legokor/drone/FC_hardware/FC/Symbols/snapeda/3dmodels/SM08B-SRSS-TB.step

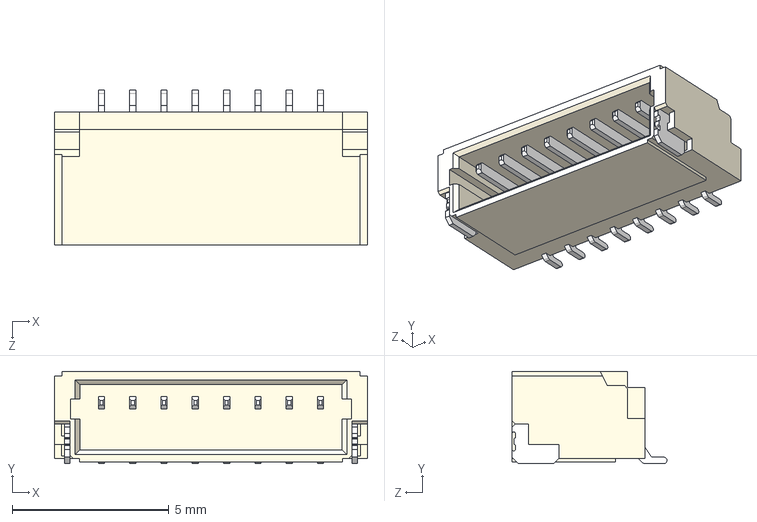
[picture p2: CAD file, 2024-11-20]
FC_hardware/FC/Symbols/snapeda/3dmodels/SM08B-SRSS-TB.step
10.00 x 2.95 x 4.95 mm
