legokor/drone/FC_hardware/FC/FC.kicad_pcb

## KiCad design FC_hardware/FC/FC.kicad_pcb (2024-11-20)

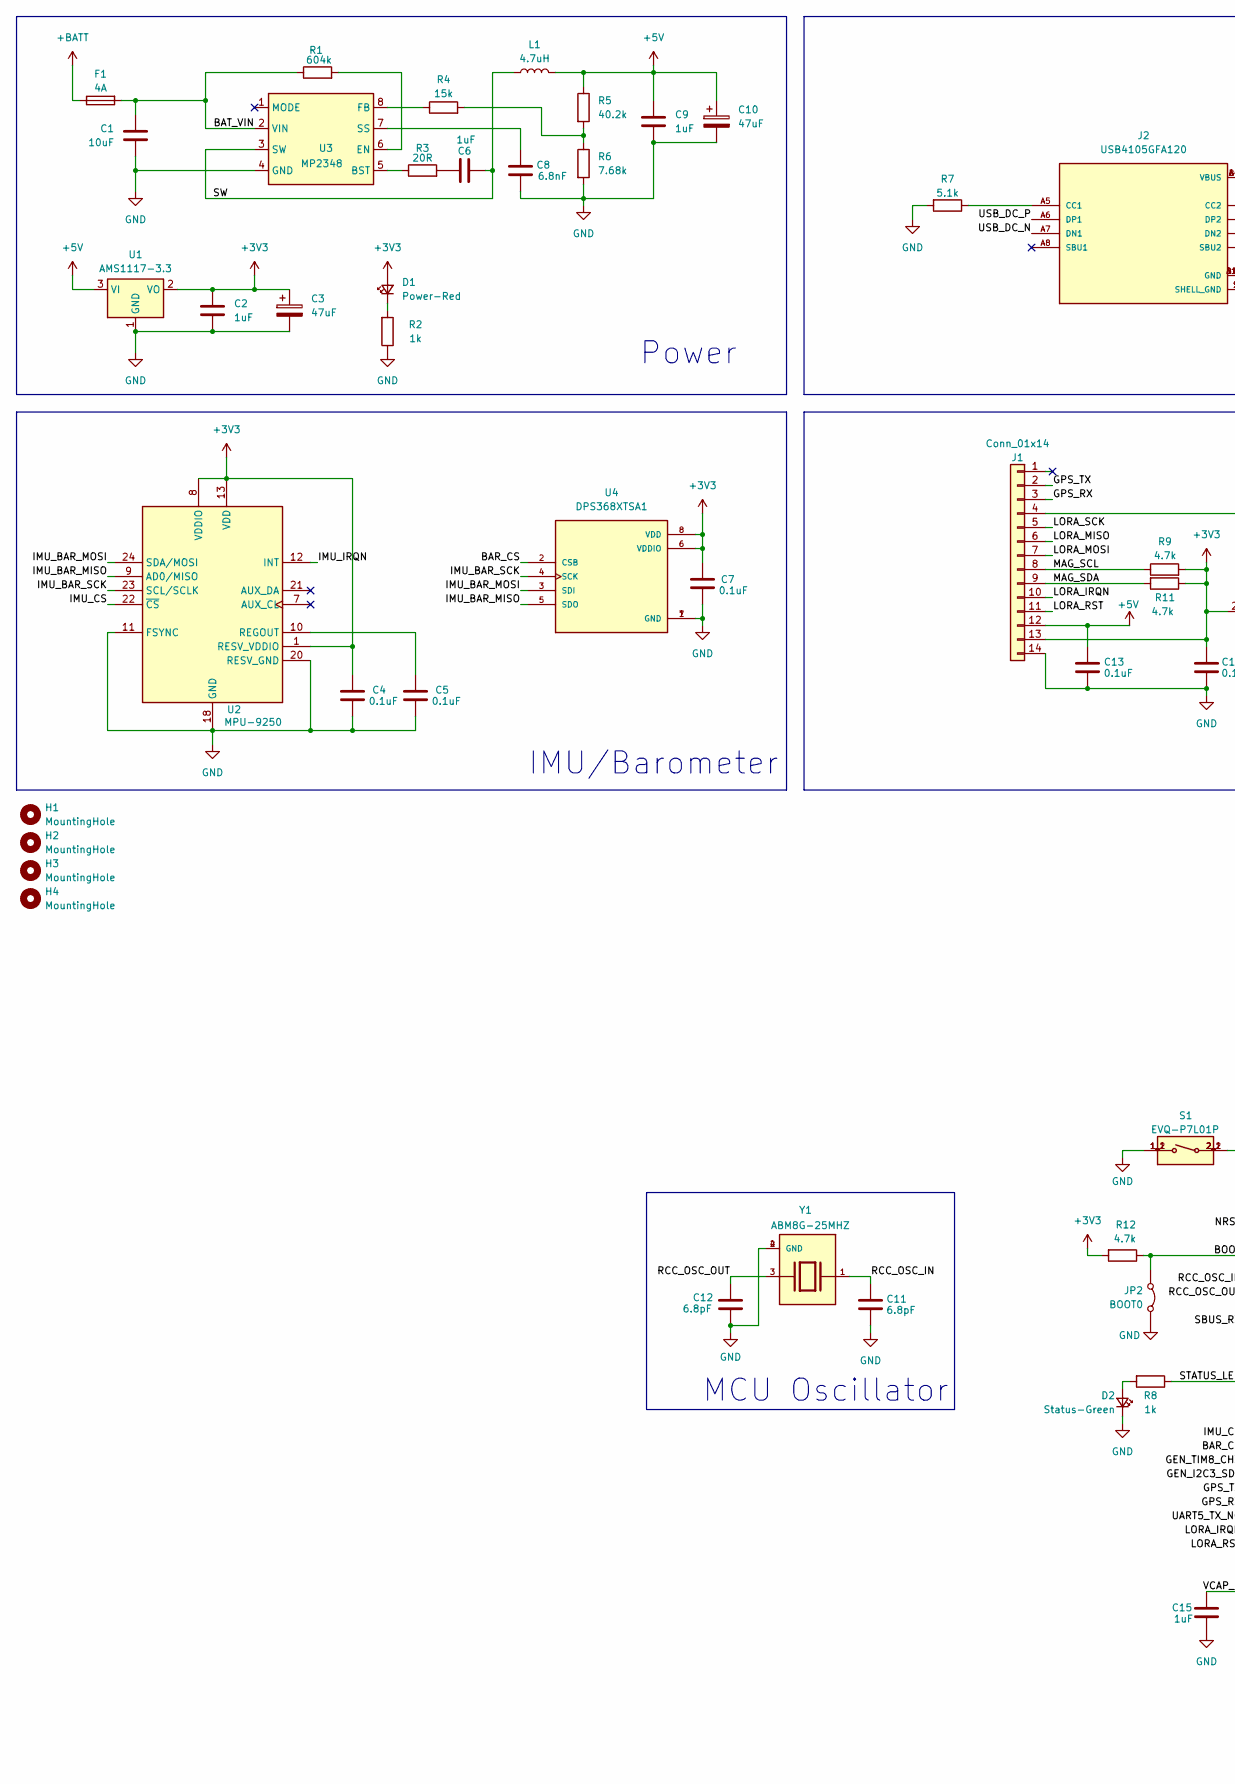
[picture p3: schematic FC.kicad_sch, Drone FC, part in row 1, column 1]

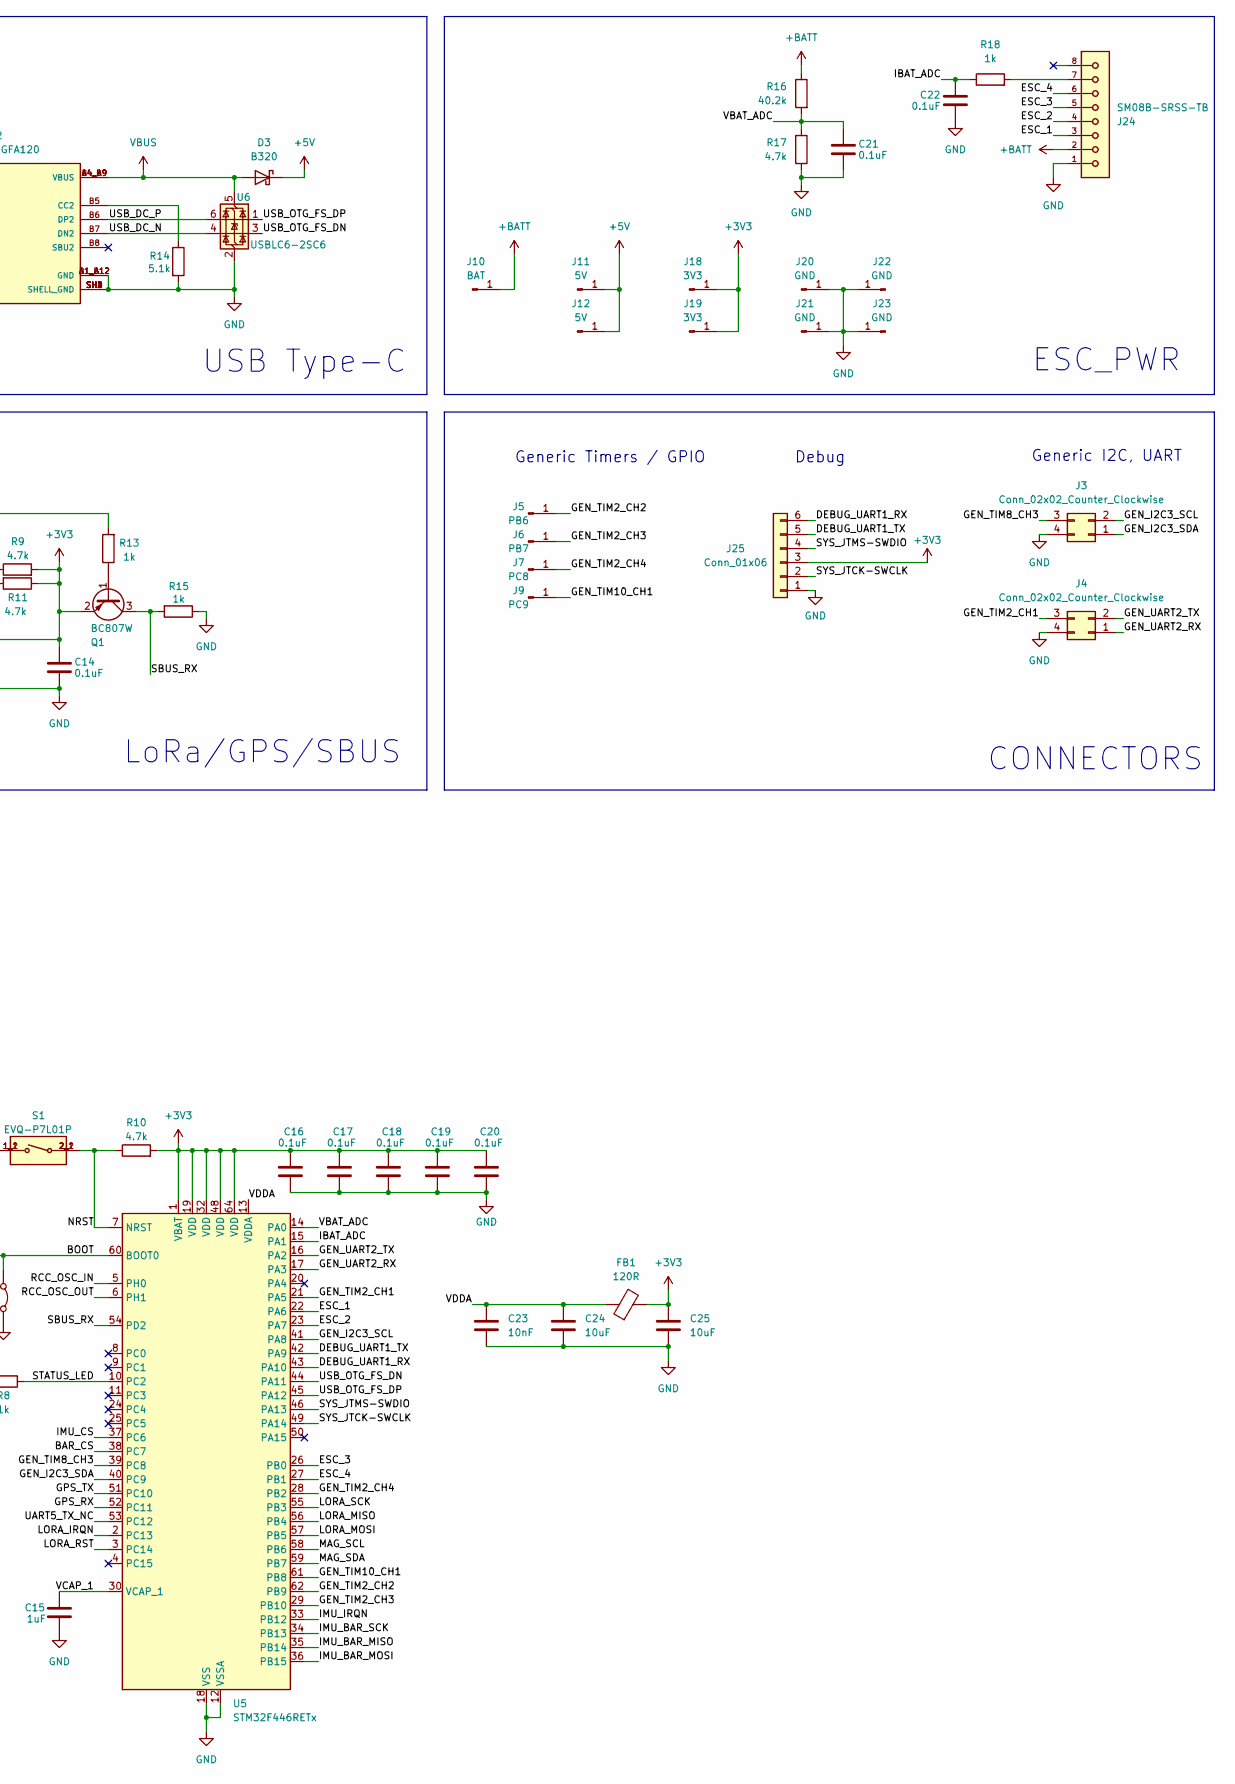
[picture p4: schematic FC.kicad_sch, Drone FC, part in row 1, column 2]

Parts:
C1: 10uF; C_1206_3216Metric
C2, C6, C9, C15: 1uF; C_0805_2012Metric
C3, C10: 47uF; CP_EIA-3528-12_Kemet-T
C4, C5, C7, C13, C14, C16, C17, C18, C19, C20, C21, C22: 0.1uF; C_0603_1608Metric
C8: 6.8nF; C_0603_1608Metric
C11, C12: 6.8pF; C_0603_1608Metric
C23: 10nF; C_0603_1608Metric
C24, C25: 10uF; C_0603_1608Metric
D1: Power-Red; LED_0805_2012Metric
D2: Status-Green; LED_0805_2012Metric
D3: B320; D_SMA
F1: 4A; Fuse_0805_2012Metric
FB1: 120R; L_1206_3216Metric
H1, H2, H3, H4: MountingHole; MountingHole_3.2mm_M3
J1: Conn_01x14; JST_SH_SM14B-SRSS-TB_1x14-1MP_P1.00mm_Horizontal
J2: USB4105GFA120; GCT_USB4105GFA120; PARTREV B3
J3, J4: Conn_02x02_Counter_Clockwise; PinHeader_2x02_P1.27mm_Vertical
J5: PB6; 1.27mm_pin
J6: PB7; 1.27mm_pin
J7: PC8; 1.27mm_pin
J9: PC9; 1.27mm_pin
J10: BAT; PinHeader_1x01_P2.00mm_Vertical
J11, J12: 5V; 1.27mm_pin
J18, J19: 3V3; 1.27mm_pin
J20, J21, J22, J23: GND; 1.27mm_pin
J24: SM08B-SRSS-TB; JST_SH_SM08B-SRSS-TB_1x08-1MP_P1.00mm_Horizontal
J25: Conn_01x06; PinHeader_2x03_P1.27mm_Vertical
JP2: BOOT0; SolderJumper-2_P1.3mm_Bridged_RoundedPad1.0x1.5mm
L1: 4.7uH; L_Cenker_CKCS5040
Q1: BC807W; SOT-323_SC-70
R1: 604k; R_0603_1608Metric
R2, R8, R13, R15, R18: 1k; R_0603_1608Metric
R3: 20R; R_0603_1608Metric
R4: 15k; R_0603_1608Metric
R5, R16: 40.2k; R_0603_1608Metric
R6: 7.68k; R_0603_1608Metric
R7, R14: 5.1k; R_0603_1608Metric
R9, R10, R11, R12, R17: 4.7k; R_0603_1608Metric
S1: EVQ-P7L01P; SW_EVQ-P7L01P; PARTREV N/A
U1: AMS1117-3.3; SOT-223-3_TabPin2
U2: MPU-9250; InvenSense_QFN-24_3x3mm_P0.4mm
U3: MP2348; SOT-583-8
U4: DPS368XTSA1; XDCR_DPS368XTSA1
U5: STM32F446RETx; LQFP-64_10x10mm_P0.5mm
U6: USBLC6-2SC6; SOT-23-6
Y1: ABM8G-25MHZ; XTAL_ABM8G-25.000MHZ-4Y-T3; PARTREV 08.13.15

Connections:
+3V3: C2.1, C3.1, C4.1, C7.2, C14.1, C16.2, C17.2, C18.2, C19.2, C20.2, C25.2, D1.2 (A), FB1.2, J1.13, J18.1, J19.1, J25.3, Q1.2 (E), R9.2, R10.2, R11.1, R12.2, U1.2 (VO), U2.1 (RESV_VDDIO), U2.8 (VDDIO), U2.13 (VDD), U4.6 (VDDIO), U4.8 (VDD), U5.1 (VBAT), U5.19 (VDD), U5.32 (VDD), U5.48 (VDD), U5.64 (VDD)
+5V: C9.1, C10.1, C13.1, D3.1 (K), J1.12, J11.1, J12.1, L1.2, R5.1, U1.3 (VI)
+BATT: F1.1, J10.1, J24.2, R16.1
/BAR_CS: U4.2 (CSB), U5.38 (PC7)
/BAT_VIN: C1.1, F1.2, R1.1, U3.2 (VIN)
/BOOT: JP2.2 (B), R12.1, U5.60 (BOOT0)
/DEBUG_UART1_RX: J25.6, U5.43 (PA10)
/DEBUG_UART1_TX: J25.5, U5.42 (PA9)
/ESC_1: J24.3, U5.22 (PA6)
/ESC_2: J24.4, U5.23 (PA7)
/ESC_3: J24.5, U5.26 (PB0)
/ESC_4: J24.6, U5.27 (PB1)
/GEN_I2C3_SCL: J3.2, U5.41 (PA8)
/GEN_I2C3_SDA: J3.1, U5.40 (PC9)
/GEN_TIM2_CH1: J4.3, U5.21 (PA5)
/GEN_TIM2_CH2: J5.1, U5.62 (PB9)
/GEN_TIM2_CH3: J6.1, U5.29 (PB10)
/GEN_TIM2_CH4: J7.1, U5.28 (PB2)
/GEN_TIM8_CH3: J3.3, U5.39 (PC8)
/GEN_TIM10_CH1: J9.1, U5.61 (PB8)
/GEN_UART2_RX: J4.1, U5.17 (PA3)
/GEN_UART2_TX: J4.2, U5.16 (PA2)
/GPS_RX: J1.3, U5.52 (PC11)
/GPS_TX: J1.2, U5.51 (PC10)
/IBAT_ADC: C22.1, R18.1, U5.15 (PA1)
/IMU_BAR_MISO: U2.9 (AD0/MISO), U4.5 (SDO), U5.35 (PB14)
/IMU_BAR_MOSI: U2.24 (SDA/MOSI), U4.3 (SDI), U5.36 (PB15)
/IMU_BAR_SCK: U2.23 (SCL/SCLK), U4.4 (SCK), U5.34 (PB13)
/IMU_CS: U2.22 (~CS), U5.37 (PC6)
/IMU_IRQN: U2.12 (INT), U5.33 (PB12)
/LORA_IRQN: J1.10, U5.2 (PC13)
/LORA_MISO: J1.6, U5.56 (PB4)
/LORA_MOSI: J1.7, U5.57 (PB5)
/LORA_RST: J1.11, U5.3 (PC14)
/LORA_SCK: J1.5, U5.55 (PB3)
/MAG_SCL: J1.8, R9.1, U5.58 (PB6)
/MAG_SDA: J1.9, R11.2, U5.59 (PB7)
/NRST: R10.1, S1.2_1, S1.2_2, U5.7 (NRST)
/RCC_OSC_IN: C11.2, U5.5 (PH0), Y1.1
/RCC_OSC_OUT: C12.1, U5.6 (PH1), Y1.3
/SBUS_RX: Q1.3 (C), R15.2, U5.54 (PD2)
/STATUS_LED: R8.1, U5.10 (PC2)
/SW: C6.2, L1.1, U3.3 (SW)
/SYS_JTCK-SWCLK: J25.2, U5.49 (PA14)
/SYS_JTMS-SWDIO: J25.4, U5.46 (PA13)
/UART5_TX_NC: U5.53 (PC12)
/USB_DC_N: J2.A7 (DN1), J2.B7 (DN2), U6.4 (I/O2)
/USB_DC_P: J2.A6 (DP1), J2.B6 (DP2), U6.6 (I/O1)
/USB_OTG_FS_DN: U5.44 (PA11), U6.3 (I/O2)
/USB_OTG_FS_DP: U5.45 (PA12), U6.1 (I/O1)
/VBAT_ADC: C21.1, R16.2, R17.2, U5.14 (PA0)
/VCAP_1: C15.2, U5.30 (VCAP_1)
/VDDA: C23.2, C24.2, FB1.1, U5.13 (VDDA)
GND: C1.2, C2.2, C3.2, C4.2, C5.2, C7.1, C8.2, C9.2, C10.2, C11.1, C12.2, C13.2, C14.2, C15.1, C16.1, C17.1, C18.1, C19.1, C20.1, C21.2, C22.2, C23.1, C24.1, C25.1, D2.1 (K), J1.14, J2.A1_B12 (GND), J2.B1_A12 (GND), J2.SH1 (SHELL_GND), J2.SH2 (SHELL_GND), J2.SH3 (SHELL_GND), J2.SH4 (SHELL_GND), J3.4, J4.4, J20.1, J21.1, J22.1, J23.1, J24.1, J25.1, JP2.1 (A), R2.1, R6.2, R7.2, R14.2, R15.1, R17.1, S1.1_1, S1.1_2, U1.1 (GND), U2.11 (FSYNC), U2.18 (GND), U2.20 (RESV_GND), U3.4 (GND), U4.1 (GND), U4.7 (GND), U5.12 (VSSA), U5.18 (VSS), U5.31 (VSS), U5.47 (VSS), U5.63 (VSS), U6.2 (GND), Y1.2 (GND), Y1.4 (GND)
unnamed: C6.1, R3.2
unnamed: D1.1 (K), R2.2
unnamed: D2.2 (A), R8.2
unnamed: J1.4, R13.2
unnamed: J2.A5 (CC1), R7.1
unnamed: J2.B5 (CC2), R14.1
unnamed: J24.7, R18.2
unnamed: Q1.1 (B), R13.1
unnamed: R4.2, R5.2, R6.1
unnamed: C5.1, U2.10 (REGOUT)
unnamed: R3.1, U3.5 (BST)
unnamed: R1.2, U3.6 (EN)
unnamed: R4.1, U3.8 (FB)
unnamed: C8.1, U3.7 (SS)
VBUS: D3.2 (A), J2.A4_B9 (VBUS), J2.B4_A9 (VBUS), U6.5 (VBUS)

Notes on the sheet:
IMU/Barometer
Generic Timers / GPIO
Debug
USB Type-C
Power
Generic I2C, UART
ESC_PWR
MCU Oscillator
LoRa/GPS/SBUS
CONNECTORS

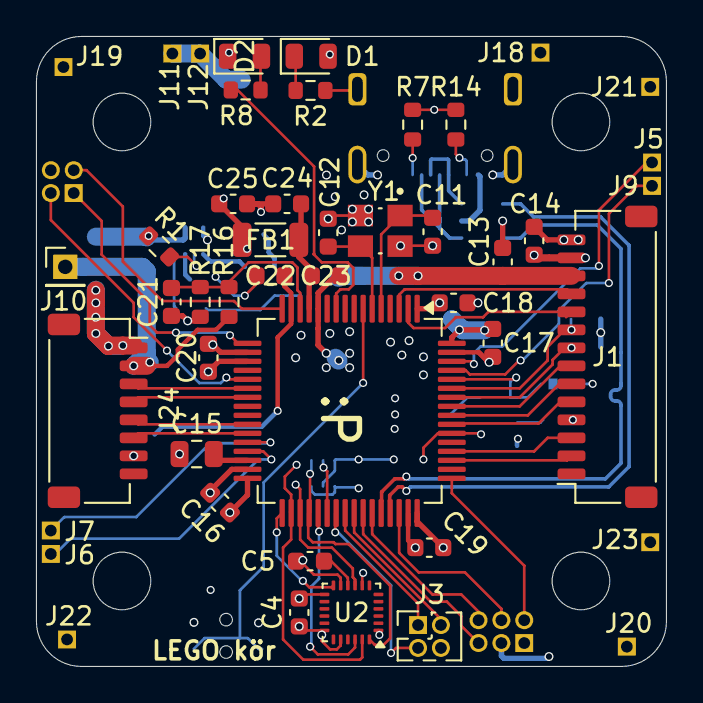
[picture p5: board FC.kicad_pcb from above]

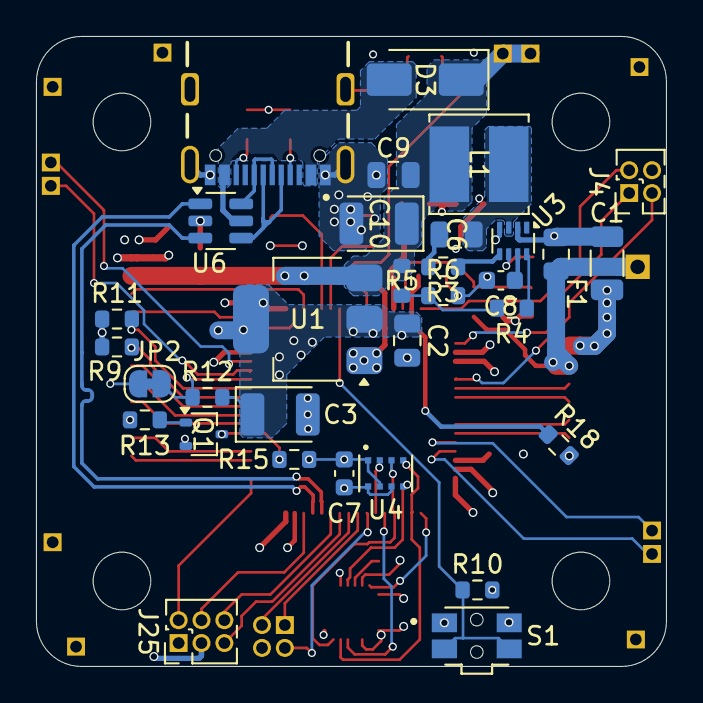
[picture p6: board FC.kicad_pcb from below]

Board: 4 copper layers, 35.0 x 35.0 mm, 82 parts (32 on the bottom side), 68 nets.
