legokor/drone/FC_firmware/FC_firmware.ioc

Mcu.UserName=STM32F446RETx
PA0-WKUP.GPIO_Label=VBAT_ADC
PA0-WKUP.Signal=ADCx_IN0
PA1.GPIO_Label=IBAT_ADC
PA1.Signal=ADCx_IN1
PA10.GPIO_Label=DEBUG_UART1_RX
PA10.Signal=USART1_RX
PA11.Signal=USB_OTG_FS_DM
PA12.Signal=USB_OTG_FS_DP
PA13.Signal=SYS_JTMS-SWDIO
PA14.Signal=SYS_JTCK-SWCLK
PA2.GPIO_Label=GEN_UART2_TX
PA2.Signal=USART2_TX
PA3.GPIO_Label=GEN_UART2_RX
PA3.Signal=USART2_RX
PA5.GPIO_Label=GEN_TIM2_CH1
PA5.Signal=S_TIM2_CH1_ETR
PA6.GPIO_Label=ESC_1
PA6.Signal=S_TIM3_CH1
PA7.GPIO_Label=ESC_2
PA7.Signal=S_TIM3_CH2
PA8.GPIO_Label=GEN_I2C3_SCL
PA8.Signal=I2C3_SCL
PA9.GPIO_Label=DEBUG_UART1_TX
PA9.Signal=USART1_TX
PB0.GPIO_Label=ESC_3
PB0.Signal=S_TIM3_CH3
PB1.GPIO_Label=ESC_4
PB1.Signal=S_TIM3_CH4
PB10.GPIO_Label=GEN_TIM2_CH3
PB10.Signal=S_TIM2_CH3
PB12.GPIO_Label=IMU_IRQN
PB12.Signal=GPXTI12
PB13.GPIO_Label=IMU_BAR_SCK
PB13.Signal=SPI2_SCK
PB14.GPIO_Label=IMU_BAR_MISO
PB14.Signal=SPI2_MISO
PB15.GPIO_Label=IMU_BAR_MOSI
PB15.Signal=SPI2_MOSI
PB2.GPIO_Label=GEN_TIM2_CH4
PB2.Signal=S_TIM2_CH4
PB3.GPIO_Label=LORA_SCK
PB3.Signal=SPI1_SCK
PB4.GPIO_Label=LORA_MISO
PB4.Signal=SPI1_MISO
PB5.GPIO_Label=LORA_MOSI
PB5.Signal=SPI1_MOSI
PB6.GPIO_Label=MAG_SCL
PB6.Signal=I2C1_SCL
PB7.GPIO_Label=MAG_SDA
PB7.Signal=I2C1_SDA
PB8.GPIO_Label=GEN_TIM10_CH1
PB8.Signal=S_TIM10_CH1
PB9.GPIO_Label=GEN_TIM2_CH2
PB9.Signal=S_TIM2_CH2
PC10.GPIO_Label=GPS_TX
PC10.Signal=UART4_TX
PC11.GPIO_Label=GPS_RX
PC11.Signal=UART4_RX
PC12.GPIO_Label=UART5_TX_NC
PC12.Signal=UART5_TX
PC13.GPIO_Label=LORA_IRQN
PC13.Signal=GPXTI13
PC14-OSC32_IN.GPIO_Label=LORA_RST
PC14-OSC32_IN.Signal=GPIO_Output
PC2.GPIO_Label=STATUS_LED
PC2.Signal=GPIO_Output
PC6.GPIO_Label=IMU_CS
PC6.Signal=GPIO_Output
PC7.GPIO_Label=BAR_CS
PC7.Signal=GPIO_Output
PC8.GPIO_Label=GEN_TIM8_CH3
PC8.Signal=S_TIM8_CH3
PC9.GPIO_Label=GEN_I2C3_SDA
PC9.Signal=I2C3_SDA
PD2.GPIO_Label=SBUS_RX
PD2.Signal=UART5_RX
PH0-OSC_IN.Signal=RCC_OSC_IN
PH1-OSC_OUT.Signal=RCC_OSC_OUT
