legokor/drone/FC_firmware/Src/config.h

#ifndef CONFIG_H
#define CONFIG_H

// LOG
#define config_LOG_TOPIC 0
// LOG

// DSP
#define config_DSP_LOOP_FREQ 4000
// DSP

// ACT
#define config_ACT_MODE_PWM 1
#define config_ACT_MODE_DSHOT 2
#define config_ACT_MODE config_ACT_MODE_DSHOT

#define config_ACT_LOOP_FREQ 4000

#if config_ACT_MODE == config_ACT_MODE_PWM

#define config_ACT_PWM_ON_DISARM

#elif config_ACT_MODE == config_ACT_MODE_DSHOT

#define config_DSHOT_MODE 300

#else

#error Unknown act mode

#endif
// ACT

// LLC
#define config_LLC_ROLL_PID_CONSTS 0.005f, 0.000f, 0
#define config_LLC_PITCH_PID_CONSTS 0.005f, 0.000f, 0
#define config_LLC_YAW_PID_CONSTS -0.015f, -0.020f, 0

// checkpoint
// #define config_LLC_ROLL_PID_CONSTS 0.001f, 0, 0
// #define config_LLC_PITCH_PID_CONSTS 0.001f, 0, 0
// #define config_LLC_YAW_PID_CONSTS -0.015f, -0.020f, 0
// LLC

// RC
#define config_RC_CHAN_ARM 6
#define config_RC_CHAN_ROLL 0
#define config_RC_CHAN_PITCH 1
#define config_RC_CHAN_YAW 3
#define config_RC_CHAN_THRUST 2

#define config_RC_IDLE_DISARM_MS 200

#define config_RC_ARM_THRESHOLD 1700

#define config_RC_ROLL_PITCH_YAW_MIN -1
#define config_RC_ROLL_PITCH_YAW_MAX 1
#define config_RC_ROLL_PITCH_YAW_RANGE config_RC_ROLL_PITCH_YAW_MIN, config_RC_ROLL_PITCH_YAW_MAX

#define config_RC_THRUST_MIN 0
#define config_RC_THRUST_MAX 1
#define config_RC_THRUST_RANGE config_RC_THRUST_MIN, config_RC_THRUST_MAX

#define config_RC_ROLL_CALIB_RANGE 212, 1811
#define config_RC_PITCH_CALIB_RANGE 212, 1811
#define config_RC_YAW_CALIB_RANGE 215, 1811
#define config_RC_THRUST_CALIB_RANGE 174, 1702

// RC

// usb
#define config_BATTERRY_DISCONNECTED_VOLTAGE 3.0f

#define config_BATTERY_CELL_COUNT 4
#define config_MIN_BATTERY_CELL_VOLTAGE 3.3f
#define config_BATTERY_CRITICAL_TIME_MS 1000
#define config_BATTERY_ADC_CONVERSION_FACTOR 7.68e-3 // (1 / 130.0f)
#define config_ESC_ADC_CONVERSION_FACTOR 1           // TODO: esc adc conversion factor
#define config_TELEMETRY_FREQ 10

#endif // CONFIG_H
