legokor/drone/FC_firmware/Drivers/rc/impl/rc.c

#include "rc/rc.h"
#include "err/err.h"
#include "irq/irq.h"
#include "log/log.h"
#include "sys/time.h"
#include "utils/utils.h"

#include "stm32f4xx_hal_dma.h"

#include <string.h>

#define _rc_SBUS_CH17_MASK 0x01
#define _rc_SBUS_CH18_MASK 0x02
#define _rc_SBUS_LOST_FRAME_MASK 0x10
#define _rc_SBUS_FAILSAFE_MASK 0x20
#define _rc_SBUS_FRAME_START 0x0F
#define _rc_SBUS_FRAME_END 0x00
#define _rc_SBUS_MIN_TIME_BETWEEN_FRAMES_US (6 * 1000)

#define _rc_SBUS_CHAN_BITS 11
#define _rc_SBUS_CHAN_BYTES (_rc_SBUS_CHAN_BITS / 8 + utils_min(_rc_SBUS_CHAN_BITS % 8, 2))
#define _rc_SBUS_CHANNELS 16
#define _rc_SBUS_MASK ((1 << _rc_SBUS_CHAN_BITS) - 1)

static void _rc_handleRxCplt(void* context) {
    sys_TimeUS now = sys_time();
    rc_Rc* rc = (rc_Rc*) context;

    if (rc->state == rc_STATE_WAIT_FOR_START) {
        bool frameStart = rc->rxDMABuffer[0] == _rc_SBUS_FRAME_START;
        bool inTime = sys_timeDiff(rc->lastFrameTime, now) >= _rc_SBUS_MIN_TIME_BETWEEN_FRAMES_US;
        if (frameStart && inTime) {
            rc->state = rc_STATE_RECEIVING;

            HAL_UART_Receive_DMA(rc->huart, (uint8_t*) rc->rxDMABuffer + 1, _rc_SBUS_FRAME_SIZE - 1);

            // HAL enables it every time...
            __HAL_DMA_DISABLE_IT(rc->huart->hdmarx, DMA_IT_HT);
        } else {
            HAL_UART_Receive_IT(rc->huart, (uint8_t*) rc->rxDMABuffer, 1);
            rc->frameValid = false;
        }
    } else if (rc->state == rc_STATE_RECEIVING) {
        rc->frameValid = rc->rxDMABuffer[_rc_SBUS_FRAME_SIZE - 1] == _rc_SBUS_FRAME_END;
        rc->state = rc_STATE_WAIT_FOR_START;

        memcpy((uint8_t*) rc->rxDataBuffer, (uint8_t*) rc->rxDMABuffer, _rc_SBUS_FRAME_SIZE);

        HAL_UART_Receive_IT(rc->huart, (uint8_t*) rc->rxDMABuffer, 1);
    }

    rc->lastFrameTime = now;
}

bool rc_init(rc_Rc* const rc, UART_HandleTypeDef* const huart) {
    log_debug("Initializing rc...");

    rc->huart = huart;
    rc->frameValid = false;
    rc->state = rc_STATE_WAIT_FOR_START;
    rc->lastFrameTime = sys_time();

    irq_subscribeToIrq(irq_UART_RX_CPLT, _rc_handleRxCplt, rc, huart);

    err_try(HAL_UART_Receive_IT(huart, (uint8_t*) rc->rxDataBuffer, 1) == HAL_OK);

    return true;
}

// aaaaaaaa
// aaabbbbb
// bbbbbbcc
// cccccccc
// cddddddd
// dddd

// 00000aaaaaaaaaaa
// 00000bbbbbbbbbbb
// 00000ccccccccccc
// 00000ddddddddddd
static void _rc_parseData(const uint8_t* restrict buff, rc_RxPackage* data) {
    // same as the hard-coded version on O3

    // for (size_t c = 0; c < _rc_SBUS_CHANNELS; c++) {
    //     size_t bit_pos = c * _rc_SBUS_CHAN_BITS;
    //     size_t bit_offset = bit_pos % 8;
    //     size_t byte_pos = bit_pos / 8;
    //
    //     uint32_t d = 0;
    //     for (int i = 0; i < _rc_SBUS_CHAN_BYTES; i++)
    //         d |= buff[byte_pos + i] << (i * 8);
    //
    //     data->channels[c] = (d >> bit_offset) & _rc_SBUS_MASK;
    // }

    data->channels[16] = (buff[23] & _rc_SBUS_CH17_MASK) > 0;
    data->channels[17] = (buff[23] & _rc_SBUS_CH18_MASK) > 0;
    data->frameLost = (buff[23] & _rc_SBUS_LOST_FRAME_MASK) > 0;
    data->failsafeActive = (buff[23] & _rc_SBUS_FAILSAFE_MASK) > 0;

    data->channels[0] = (buff[1] | ((buff[2] << 8) & 0x07FF)) & 0x07FF;
    data->channels[1] = ((buff[2] >> 3) | ((buff[3] << 5) & 0x07FF)) & 0x07FF;
    data->channels[2] = ((buff[3] >> 6) | (buff[4] << 2) | ((buff[5] << 10) & 0x07FF)) & 0x07FF;
    data->channels[3] = ((buff[5] >> 1) | ((buff[6] << 7) & 0x07FF)) & 0x07FF;
    data->channels[4] = ((buff[6] >> 4) | ((buff[7] << 4) & 0x07FF)) & 0x07FF;
    data->channels[5] = ((buff[7] >> 7) | (buff[8] << 1) | ((buff[9] << 9) & 0x07FF)) & 0x07FF;
    data->channels[6] = ((buff[9] >> 2) | ((buff[10] << 6) & 0x07FF)) & 0x07FF;
    data->channels[7] = ((buff[10] >> 5) | ((buff[11] << 3) & 0x07FF)) & 0x07FF;
    data->channels[8] = (buff[12] | ((buff[13] << 8) & 0x07FF)) & 0x07FF;
    data->channels[9] = ((buff[13] >> 3) | ((buff[14] << 5) & 0x07FF)) & 0x07FF;
    data->channels[10] = ((buff[14] >> 6) | (buff[15] << 2) | ((buff[16] << 10) & 0x07FF)) & 0x07FF;
    data->channels[11] = ((buff[16] >> 1) | ((buff[17] << 7) & 0x07FF)) & 0x07FF;
    data->channels[12] = ((buff[17] >> 4) | ((buff[18] << 4) & 0x07FF)) & 0x07FF;
    data->channels[13] = ((buff[18] >> 7) | (buff[19] << 1) | ((buff[20] << 9) & 0x07FF)) & 0x07FF;
    data->channels[14] = ((buff[20] >> 2) | ((buff[21] << 6) & 0x07FF)) & 0x07FF;
    data->channels[15] = ((buff[21] >> 5) | ((buff[22] << 3) & 0x07FF)) & 0x07FF;
}

bool rc_getData(const rc_Rc* rc, rc_RxPackage* data) {
    HAL_NVIC_DisableIRQ(rc->writeIrq);
    if (!rc->frameValid) {
        HAL_NVIC_EnableIRQ(rc->writeIrq);
        return false;
    }

    uint8_t buff[_rc_SBUS_FRAME_SIZE];
    memcpy(buff, (const uint8_t*) rc->rxDataBuffer, _rc_SBUS_FRAME_SIZE);
    HAL_NVIC_EnableIRQ(rc->writeIrq);

    _rc_parseData(buff, data);

    return true;
}
