legokor/drone/(commit log)

2024-09-01 Power section complete
    [FC.kicad_sch]
2024-09-11 STM pin config added
    [FC.kicad_sch]
2024-09-13 schematic things...
    [FC.kicad_pcb, FC.kicad_sch]
2024-09-15 schematic is done
    [FC.kicad_sch]
2024-09-15 PCB DRC and outline
    [FC.kicad_pcb]
2024-09-18 footprint and PCB outline changes
    [FC.kicad_pcb, FC.kicad_sch]
2024-09-22 0201 changed to 0603
    [FC.kicad_sch]
2024-09-22 fixup! 0201 changed to 0603
    [FC.kicad_pcb]
2024-09-28 Pin config changed, LoRa module removed from board
    [FC.kicad_pcb, FC.kicad_sch]
2024-10-04 Improve schematic, settings
    [FC.kicad_sch]
2024-10-04 Add gerbers to gitignore
2024-10-04 Board outline, DRU
    [FC.kicad_pcb]
2024-10-16 stm pin config updated, TODO: schematic update
2024-10-23 Update stm pin config, clean up schematic
    [FC.kicad_sch]
2024-11-08 Dump pcb design
    [FC.kicad_pcb, FC.kicad_sch, SM08B-SRSS-TB.step]
2024-11-11 min via hole d enlarged to 0.3mm and all vias resized accordingly
    [FC.kicad_pcb]
2024-11-13 Finalize design
    [FC.kicad_pcb, FC.kicad_sch]
2024-11-28 Generate driver modules
2025-02-07 Fix includes in gen
    [act.c]
2025-02-10 Remove hardcoded spi refs from bar driver
2025-05-03 minor fixes, temporary module removal
    [FC_firmware.ioc, bar.c, sys.c]
2025-05-03 UART, IMU and INT modules
2025-05-03 functional IMU test code
2025-05-03 esc test
2025-05-03 fixes and barometer test code
    [act.c, bar.c, imu.c]
2025-05-03 rc driver initial impl
2025-05-03 sbus rc receiver driver working impl
2025-05-07 Remove timer init code
    Will be generated by MX
2025-05-14 Review imu, rc, uart
    Fix buffering in rc + code style changes to imu and uart.
    [imu.c, rc.c]
2025-05-22 Fix naming, minor refactors
    [act.c, bar.c]
2025-06-19 Fix interrupt naming
2025-06-19 Add HAL dma sources to cmake
2025-06-19 Fix arm gcc download link
2025-06-25 Use winget on windows-2025
2025-09-19 Add float printf support, link-time optimalization
2025-09-19 Refactor, add more error handling to imu driver
    [imu.c]
2025-09-19 Fix typo in uart
    [uart.c]
2025-09-26 Log refactors, sys printing
2025-12-03 Full stack integrated, arm/disarm works
2026-03-10 Minor fixes, add ADC module
    [act.c, config.h, sys.c]
2026-03-18 Update HAL version, modify adc settings with MX, generate
2026-03-18 Battery threshold
2026-03-18 IMU bugfix
2026-03-18 Fix voltage stuff
2026-03-19 Use DMA to make ADC completely automatic
2026-06-03 Constanly keep PWM at 0
2026-06-11 IMU fix?
2026-06-11 Make disarmed pwm toggleable
2026-06-17 Update act to be modular, add dshot driver
2026-06-18 IMU working
2026-06-18 Revert to pwm
2026-06-25 working together with imu now
2026-08-14 Better RC calibration, minor fixes, refactors
